mkvenkit/electronut-youtube/README.md

# electronut-youtube
Projects from the Electronut Labs Youtube Channel
