mkvenkit/electronut-youtube/001-pico-th-epaper-display/docs/adafruit-sch.png

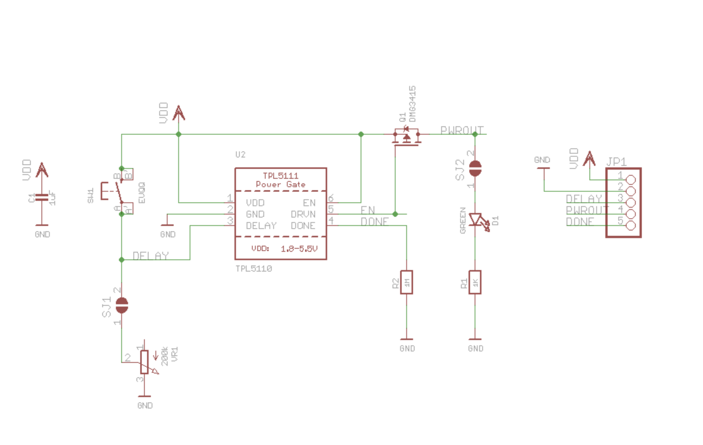
001-pico-th-epaper-display/docs/adafruit-sch.png
