mkvenkit/electronut-youtube/001-pico-th-epaper-display/docs/epaper-dims.png

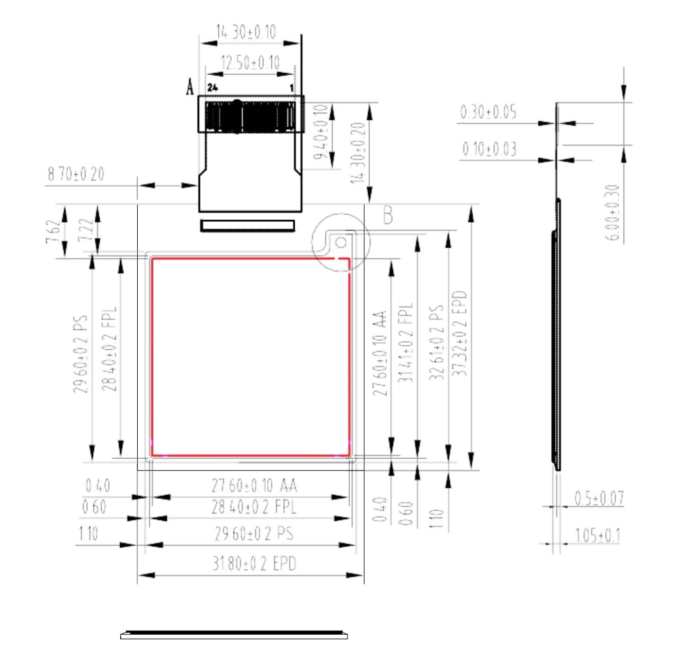
001-pico-th-epaper-display/docs/epaper-dims.png
