mkvenkit/electronut-youtube/001-pico-th-epaper-display/docs/waveshare-outline.png

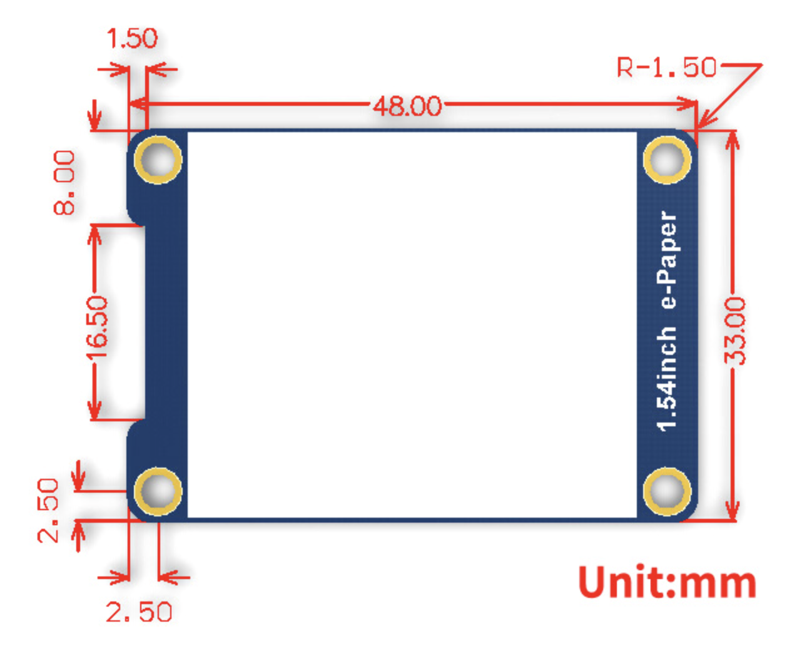
001-pico-th-epaper-display/docs/waveshare-outline.png
