mkvenkit/electronut-youtube/001-pico-th-epaper-display/pcb/qr.png

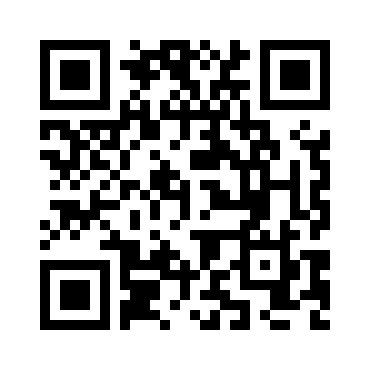
001-pico-th-epaper-display/pcb/qr.png
