mkvenkit/electronut-youtube/001-pico-th-epaper-display/pcb/.step

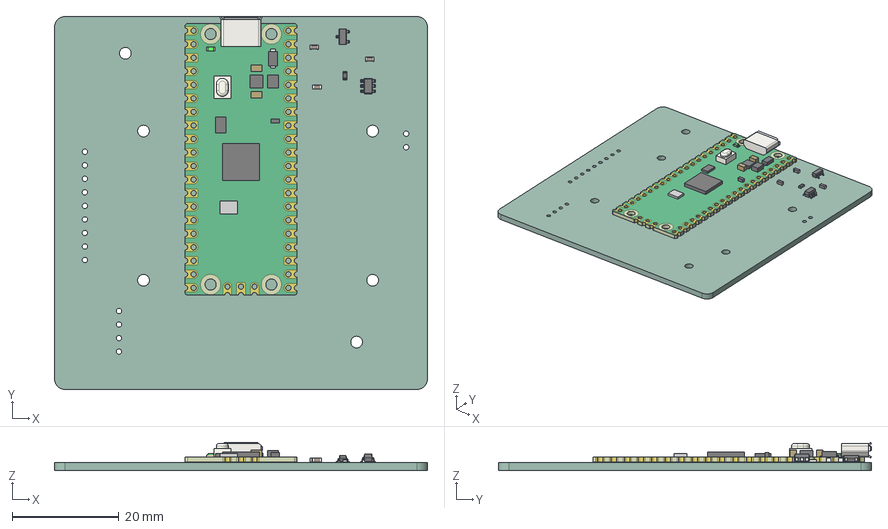
[picture p5: CAD file, 2026-04-19]
001-pico-th-epaper-display/pcb/.step
70.0 x 70.0 x 5.29 mm
C_0603_1608Metric x 3
SOT-23-6
SOT-23
RaspberryPi_Pico_Module_KiCad
R_0603_1608Metric
pico-epaper-th_PCB
