mkvenkit/electronut-youtube/(list of files, cad)

Other CAD files:
pico-th-epaper-display/pcb/pcb.step
