mkvenkit/electronut-youtube/001-pico-th-epaper-display/pcb/pico-epaper-th-sch.pdf

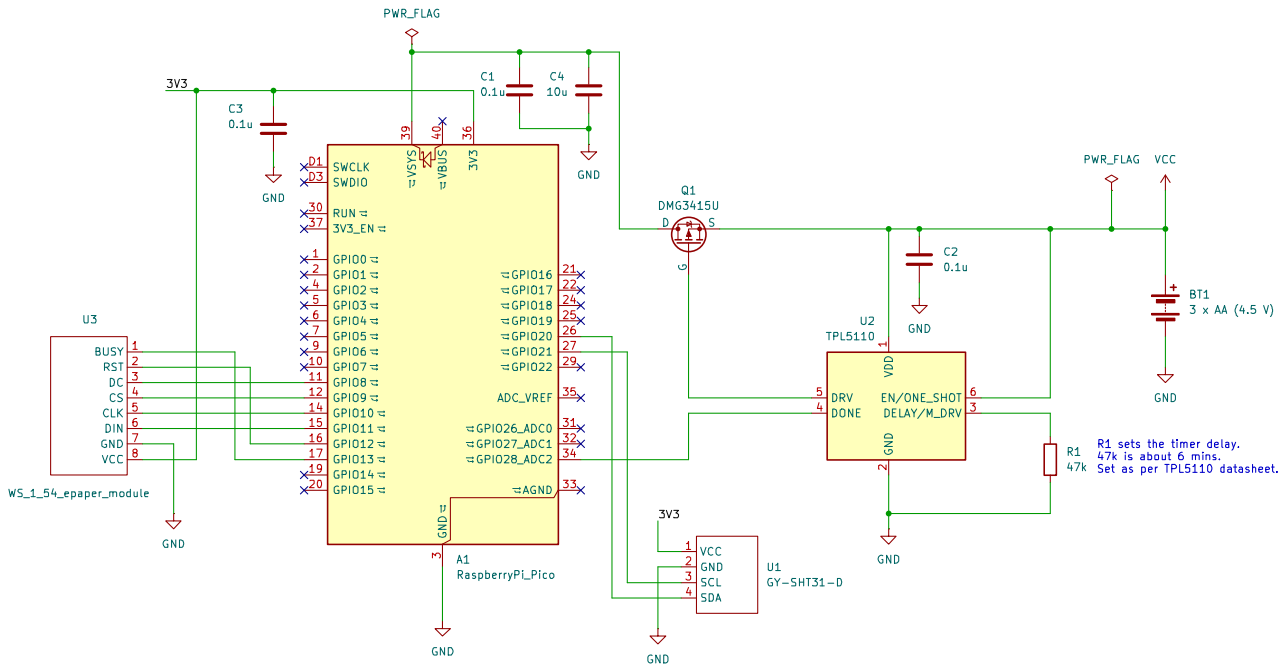
[picture p6: page 1]
