mkvenkit/electronut-youtube/001-pico-th-epaper-display/pcb/pico-epaper-th.kicad_pcb

## KiCad design 001-pico-th-epaper-display/pcb/pico-epaper-th.kicad_pcb (2026-04-28)

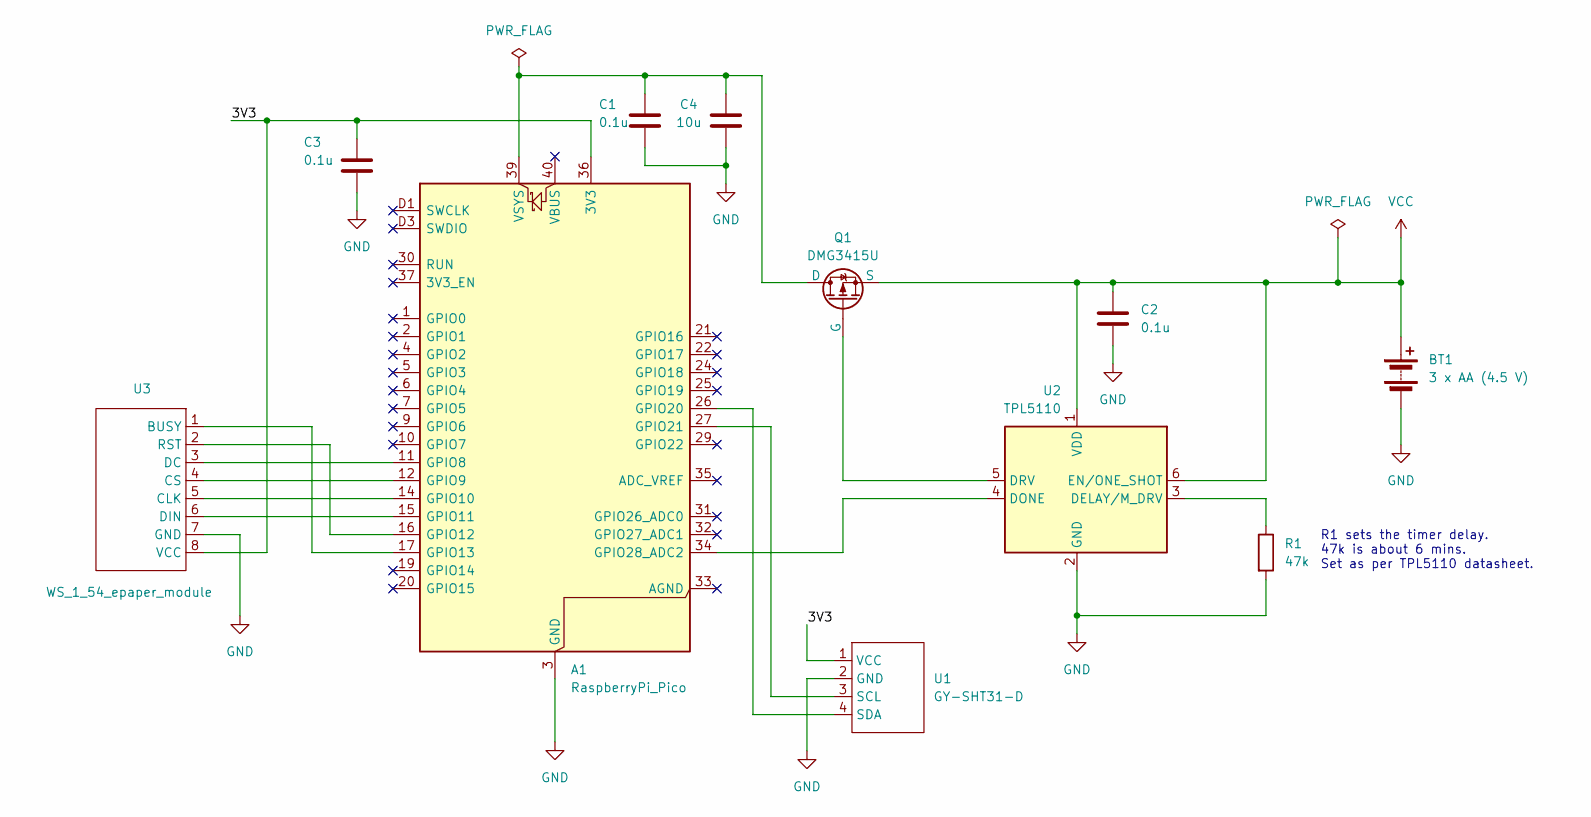
[picture p7: schematic pico-epaper-th.kicad_sch, Low Power Pico T/H Display]

Parts:
A1: RaspberryPi_Pico; RaspberryPi_Pico_SMD_HandSolder
BT1: 3 x AA (4.5 V); PinHeader_1x02_P2.54mm_Vertical
C1, C2, C3: 0.1u; C_0603_1608Metric_Pad1.08x0.95mm_HandSolder
C4: 10u; C_0603_1608Metric_Pad1.08x0.95mm_HandSolder
Q1: DMG3415U; SOT-23_Handsoldering
R1: 47k; R_0603_1608Metric_Pad0.98x0.95mm_HandSolder
U1: GY-SHT31-D; PinHeader_1x04_P2.54mm_Vertical
U2: TPL5110; SOT-23-6
U3: WS_1_54_epaper_module; PinHeader_1x08_P2.54mm_Vertical

Connections:
/3V3: A1.36 (3V3), C3.1, U1.1 (VCC), U3.8 (VCC)
GND: A1.3 (GND), A1.8 (GND), A1.13 (GND), A1.18 (GND), A1.23 (GND), A1.28 (GND), A1.38 (GND), A1.D2 (GND), BT1.2 (-), C1.2, C2.2, C3.2, C4.2, R1.2, U1.2 (GND), U2.2 (GND), U3.7 (GND)
unnamed: A1.11 (GPIO8), U3.3 (DC)
unnamed: A1.12 (GPIO9), U3.4 (CS)
unnamed: A1.14 (GPIO10), U3.5 (CLK)
unnamed: A1.15 (GPIO11), U3.6 (DIN)
unnamed: A1.16 (GPIO12), U3.2 (RST)
unnamed: A1.17 (GPIO13), U3.1 (BUSY)
unnamed: A1.26 (GPIO20), U1.4 (SDA)
unnamed: A1.27 (GPIO21), U1.3 (SCL)
unnamed: A1.34 (GPIO28_ADC2), U2.4 (DONE)
unnamed: A1.39 (VSYS), C1.1, C4.1, Q1.3 (D)
unnamed: Q1.1 (G), U2.5 (DRV)
unnamed: R1.1, U2.3 (DELAY/M_DRV)
VCC: BT1.1 (+), C2.1, Q1.2 (S), U2.1 (VDD), U2.6 (EN/ONE_SHOT)

Notes on the sheet:
R1 sets the timer delay. 47k is about 6 mins. Set as per TPL5110 datasheet.

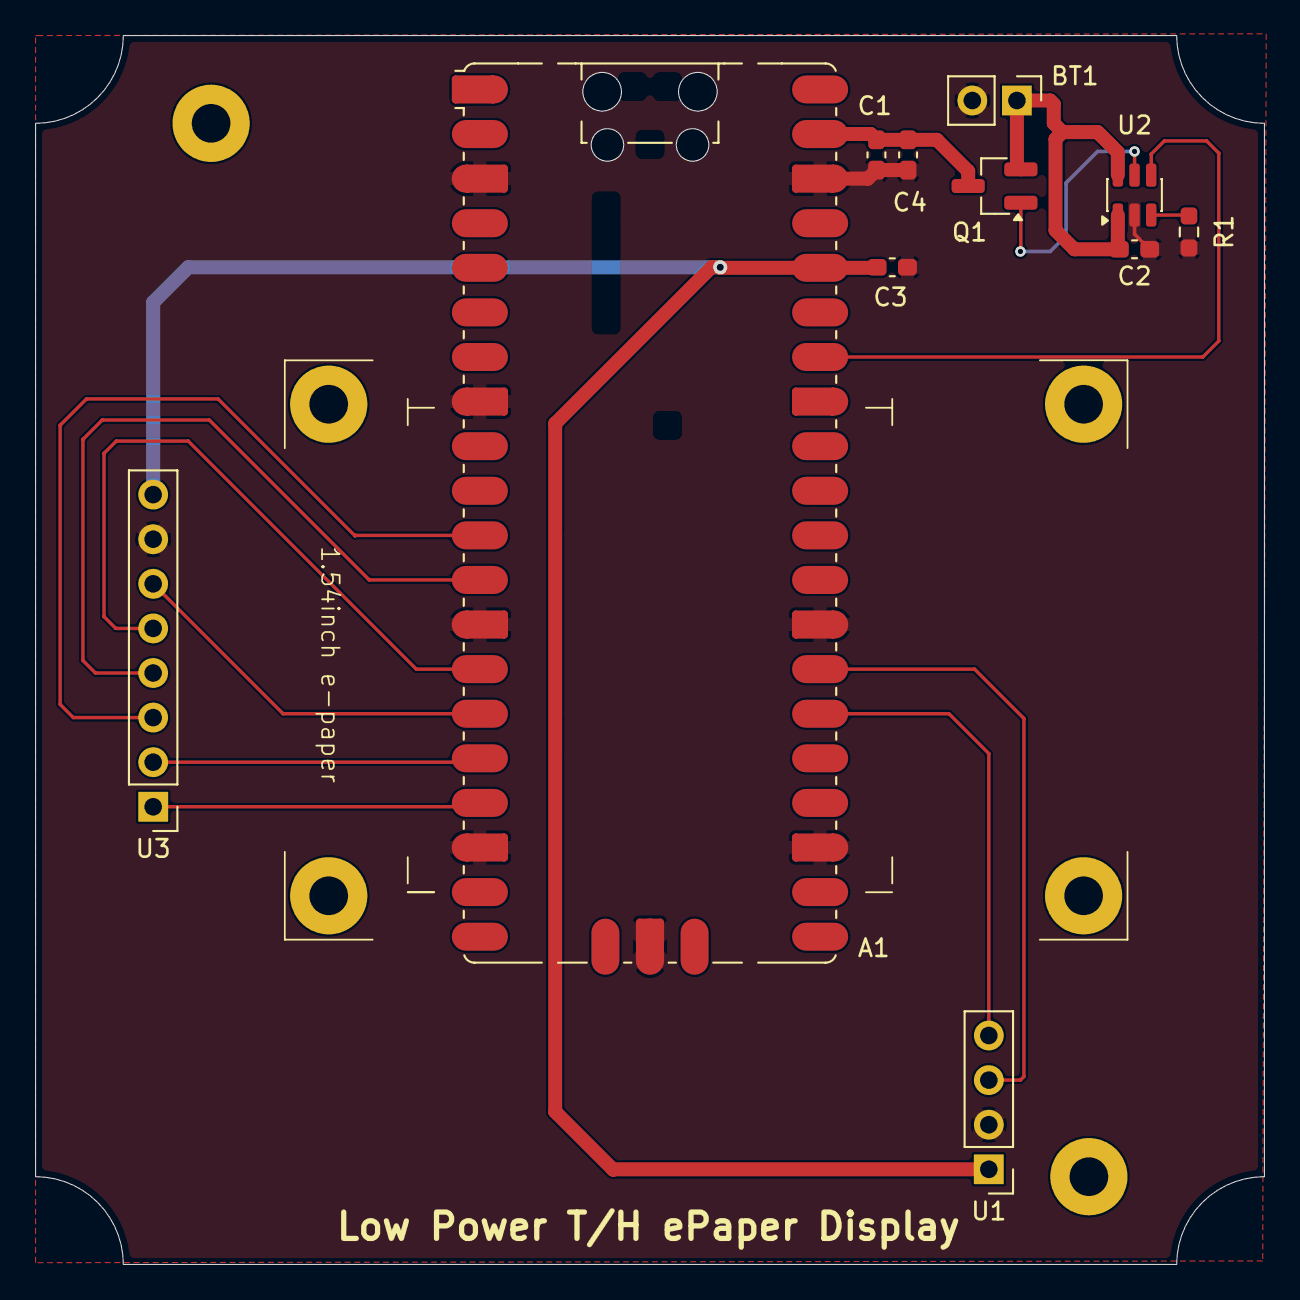
[picture p8: board pico-epaper-th.kicad_pcb from above]

Board: 2 copper layers, 70.0 x 70.0 mm, 11 parts (0 on the bottom side), 15 nets.
