mkvenkit/electronut-youtube/(commit log)

2026-04-10 added firmware
    [pico-epaper-th.kicad_pcb, pico-epaper-th.kicad_sch]
2026-04-11 fw updated
    1. done signal
    2. start up issues
    [epd_1in54.py, main.py]
2026-04-12 updated pcb design
    [pico-epaper-th.kicad_pcb, pico-epaper-th.kicad_sch, pico-epaper-th.scad]
2026-04-12 switched DONE to GP28 for ease of routing
2026-04-12 updated pcb
    [pico-epaper-th.kicad_pcb, pico-epaper-th.kicad_sch]
2026-04-19 pcb updated
    [.step, pcb.step, pico-epaper-th.kicad_pcb, pico-epaper-th.kicad_sch]
2026-04-19 added curved corners
    [pico-epaper-th.kicad_pcb]
2026-04-19 added epaper 3d
    [pico-epaper-th.kicad_pcb]
2026-04-19 added battery
    [AABattery Holder.stp, pico-epaper-th.kicad_pcb]
2026-04-20 name change
    [.step, AABattery Holder.stp, pico-epaper-th.kicad_pcb, pico-epaper-th.kicad_sch, pico-epaper-th.scad]
2026-04-20 pin changed for sht31
    [pico-epaper-th.kicad_pcb, pico-epaper-th.kicad_sch]
2026-04-21 turn of led
2026-04-21 schematic updated
    [pico-epaper-th.kicad_sch]
2026-04-22 pcb routing
    [pico-epaper-th.kicad_pcb]
2026-04-22 pcb rounting
    [pico-epaper-th.kicad_pcb]
2026-04-25 updated trace
    [pico-epaper-th.kicad_pcb]
2026-04-25 fixed drc errors on pcb
    [pico-epaper-th.kicad_pcb]
2026-04-27 removed locked silk
    [pico-epaper-th.kicad_pcb, pico-epaper-th.kicad_sch]
2026-04-28 added ver
    [pico-epaper-th.kicad_pcb]
2026-05-07 turn leds off
    [pico-epaper-th.kicad_sch]
